YoussefBMK/viaduct/layouts/README.md

Hand-created KiCad board files live here, one directory per board:

    layouts/<board>/<board>.kicad_pcb

They are made by importing viaduct_v0.net in KiCad's PCB Editor -- see the README.
SKiDL cannot generate a board, so these files are not reproducible from source and are
committed as the source of truth for the physical layout.
