YoussefBMK/viaduct/viaduct_v0_sklib.py

from collections import defaultdict
from skidl import Pin, Part, Alias, SchLib, SKIDL, TEMPLATE

from skidl.pin import pin_types

SKIDL_lib_version = '0.0.1'

viaduct_v0 = SchLib(tool=SKIDL).add_parts(*[
        Part(**{ 'name':'USB_C_Receptacle_USB2.0_16P', 'dest':TEMPLATE, 'tool':SKIDL, 'aliases':Alias({'USB_C_Receptacle_USB2.0_16P'}), 'ref_prefix':'J', 'fplist':[''], 'footprint':'Connector_USB:USB_C_Receptacle_GCT_USB4105-xx-A_16P_TopMnt_Horizontal', 'keywords':'usb universal serial bus type-C USB2.0', 'description':'USB 2.0-only 16P Type-C Receptacle connector', 'datasheet':'https://www.usb.org/sites/default/files/documents/usb_type-c.zip', 'pins':[
            Pin(num='A1',name='GND',func=pin_types.PASSIVE,unit=1),
            Pin(num='A4',name='VBUS',func=pin_types.PASSIVE,unit=1),
            Pin(num='A5',name='CC1',func=pin_types.BIDIR,unit=1),
            Pin(num='A6',name='D+',func=pin_types.BIDIR,unit=1),
            Pin(num='A7',name='D-',func=pin_types.BIDIR,unit=1),
            Pin(num='A8',name='SBU1',func=pin_types.BIDIR,unit=1),
            Pin(num='A9',name='VBUS',func=pin_types.PASSIVE,unit=1),
            Pin(num='A12',name='GND',func=pin_types.PASSIVE,unit=1),
            Pin(num='B1',name='GND',func=pin_types.PASSIVE,unit=1),
            Pin(num='B4',name='VBUS',func=pin_types.PASSIVE,unit=1),
            Pin(num='B5',name='CC2',func=pin_types.BIDIR,unit=1),
            Pin(num='B6',name='D+',func=pin_types.BIDIR,unit=1),
            Pin(num='B7',name='D-',func=pin_types.BIDIR,unit=1),
            Pin(num='B8',name='SBU2',func=pin_types.BIDIR,unit=1),
            Pin(num='B9',name='VBUS',func=pin_types.PASSIVE,unit=1),
            Pin(num='B12',name='GND',func=pin_types.PASSIVE,unit=1),
            Pin(num='SH',name='SHIELD',func=pin_types.PASSIVE,unit=1)], 'unit_defs':[] }),
        Part(**{ 'name':'R', 'dest':TEMPLATE, 'tool':SKIDL, 'aliases':Alias({'R'}), 'ref_prefix':'R', 'fplist':[''], 'footprint':'Resistor_SMD:R_0603_1608Metric', 'keywords':'R res resistor', 'description':'Resistor', 'datasheet':'', 'pins':[
            Pin(num='1',func=pin_types.PASSIVE,unit=1),
            Pin(num='2',func=pin_types.PASSIVE,unit=1)], 'unit_defs':[] }),
        Part(**{ 'name':'USBLC6-2SC6', 'dest':TEMPLATE, 'tool':SKIDL, 'aliases':Alias({'USBLC6-2SC6'}), 'ref_prefix':'U', 'fplist':['Package_TO_SOT_SMD:SOT-666', 'Package_TO_SOT_SMD:SOT-23-6'], 'footprint':'Package_TO_SOT_SMD:SOT-666', 'keywords':'usb ethernet video', 'description':'Very low capacitance ESD protection diode, 2 data-line, SOT-23-6', 'datasheet':'https://www.st.com/resource/en/datasheet/usblc6-2.pdf', 'pins':[
            Pin(num='1',name='I/O1',func=pin_types.PASSIVE,unit=1),
            Pin(num='2',name='GND',func=pin_types.PASSIVE,unit=1),
            Pin(num='3',name='I/O2',func=pin_types.PASSIVE,unit=1),
            Pin(num='4',name='I/O2',func=pin_types.PASSIVE,unit=1),
            Pin(num='5',name='VBUS',func=pin_types.PASSIVE,unit=1),
            Pin(num='6',name='I/O1',func=pin_types.PASSIVE,unit=1)], 'unit_defs':[] }),
        Part(**{ 'name':'AP2112K-3.3', 'dest':TEMPLATE, 'tool':SKIDL, 'aliases':Alias({'AP2112K-3.3'}), 'ref_prefix':'U', 'fplist':['Package_TO_SOT_SMD:SOT-23-5', 'Package_TO_SOT_SMD:SOT-23-5'], 'footprint':'Package_TO_SOT_SMD:SOT-23-5', 'keywords':'linear regulator ldo fixed positive', 'description':'600mA low dropout linear regulator, with enable pin, 3.8V-6V input voltage range, 3.3V fixed positive output, SOT-23-5', 'datasheet':'https://www.diodes.com/assets/Datasheets/AP2112.pdf', 'pins':[
            Pin(num='1',name='VIN',func=pin_types.PWRIN,unit=1),
            Pin(num='2',name='GND',func=pin_types.PWRIN,unit=1),
            Pin(num='3',name='EN',func=pin_types.INPUT,unit=1),
            Pin(num='4',name='NC',func=pin_types.NOCONNECT,unit=1),
            Pin(num='5',name='VOUT',func=pin_types.PWROUT,unit=1)], 'unit_defs':[] }),
        Part(**{ 'name':'C', 'dest':TEMPLATE, 'tool':SKIDL, 'aliases':Alias({'C'}), 'ref_prefix':'C', 'fplist':[''], 'footprint':'Capacitor_SMD:C_0603_1608Metric', 'keywords':'cap capacitor', 'description':'Unpolarized capacitor', 'datasheet':'', 'pins':[
            Pin(num='1',func=pin_types.PASSIVE,unit=1),
            Pin(num='2',func=pin_types.PASSIVE,unit=1)], 'unit_defs':[] }),
        Part(**{ 'name':'ESP32-S3-WROOM-1', 'dest':TEMPLATE, 'tool':SKIDL, 'aliases':Alias({'ESP32-S3-WROOM-1'}), 'ref_prefix':'U', 'fplist':['RF_Module:ESP32-S3-WROOM-1'], 'footprint':'RF_Module:ESP32-S3-WROOM-1', 'keywords':'RF Radio BT ESP ESP32-S3 Espressif onboard PCB antenna', 'description':'RF Module, ESP32-S3 SoC, Wi-Fi 802.11b/g/n, Bluetooth, BLE, 32-bit, 3.3V, onboard antenna, SMD', 'datasheet':'https://www.espressif.com/sites/default/files/documentation/esp32-s3-wroom-1_wroom-1u_datasheet_en.pdf', 'pins':[
            Pin(num='1',name='GND',func=pin_types.PWRIN,unit=1),
            Pin(num='2',name='3V3',func=pin_types.PWRIN,unit=1),
            Pin(num='3',name='EN',func=pin_types.INPUT,unit=1),
            Pin(num='4',name='IO4',func=pin_types.BIDIR,unit=1),
            Pin(num='5',name='IO5',func=pin_types.BIDIR,unit=1),
            Pin(num='6',name='IO6',func=pin_types.BIDIR,unit=1),
            Pin(num='7',name='IO7',func=pin_types.BIDIR,unit=1),
            Pin(num='8',name='IO15',func=pin_types.BIDIR,unit=1),
            Pin(num='9',name='IO16',func=pin_types.BIDIR,unit=1),
            Pin(num='10',name='IO17',func=pin_types.BIDIR,unit=1),
            Pin(num='11',name='IO18',func=pin_types.BIDIR,unit=1),
            Pin(num='12',name='IO8',func=pin_types.BIDIR,unit=1),
            Pin(num='13',name='USB_D-',func=pin_types.BIDIR,unit=1),
            Pin(num='14',name='USB_D+',func=pin_types.BIDIR,unit=1),
            Pin(num='15',name='IO3',func=pin_types.BIDIR,unit=1),
            Pin(num='16',name='IO46',func=pin_types.BIDIR,unit=1),
            Pin(num='17',name='IO9',func=pin_types.BIDIR,unit=1),
            Pin(num='18',name='IO10',func=pin_types.BIDIR,unit=1),
            Pin(num='19',name='IO11',func=pin_types.BIDIR,unit=1),
            Pin(num='20',name='IO12',func=pin_types.BIDIR,unit=1),
            Pin(num='21',name='IO13',func=pin_types.BIDIR,unit=1),
            Pin(num='22',name='IO14',func=pin_types.BIDIR,unit=1),
            Pin(num='23',name='IO21',func=pin_types.BIDIR,unit=1),
            Pin(num='24',name='IO47',func=pin_types.BIDIR,unit=1),
            Pin(num='25',name='IO48',func=pin_types.BIDIR,unit=1),
            Pin(num='26',name='IO45',func=pin_types.BIDIR,unit=1),
            Pin(num='27',name='IO0',func=pin_types.BIDIR,unit=1),
            Pin(num='28',name='IO35',func=pin_types.BIDIR,unit=1),
            Pin(num='29',name='IO36',func=pin_types.BIDIR,unit=1),
            Pin(num='30',name='IO37',func=pin_types.BIDIR,unit=1),
            Pin(num='31',name='IO38',func=pin_types.BIDIR,unit=1),
            Pin(num='32',name='IO39',func=pin_types.BIDIR,unit=1),
            Pin(num='33',name='IO40',func=pin_types.BIDIR,unit=1),
            Pin(num='34',name='IO41',func=pin_types.BIDIR,unit=1),
            Pin(num='35',name='IO42',func=pin_types.BIDIR,unit=1),
            Pin(num='36',name='RXD0',func=pin_types.BIDIR,unit=1),
            Pin(num='37',name='TXD0',func=pin_types.BIDIR,unit=1),
            Pin(num='38',name='IO2',func=pin_types.BIDIR,unit=1),
            Pin(num='39',name='IO1',func=pin_types.BIDIR,unit=1),
            Pin(num='40',name='GND',func=pin_types.PASSIVE,unit=1),
            Pin(num='41',name='GND',func=pin_types.PASSIVE,unit=1)], 'unit_defs':[] }),
        Part(**{ 'name':'SW_Push', 'dest':TEMPLATE, 'tool':SKIDL, 'aliases':Alias({'SW_Push'}), 'ref_prefix':'SW', 'fplist':[''], 'footprint':'Button_Switch_SMD:SW_Push_1P1T_NO_CK_KMR2', 'keywords':'switch normally-open pushbutton push-button', 'description':'Push button switch, generic, two pins', 'datasheet':'', 'pins':[
            Pin(num='1',name='1',func=pin_types.PASSIVE),
            Pin(num='2',name='2',func=pin_types.PASSIVE)], 'unit_defs':[] }),
        Part(**{ 'name':'BME280', 'dest':TEMPLATE, 'tool':SKIDL, 'aliases':Alias({'BME280'}), 'ref_prefix':'U', 'fplist':['Package_LGA:Bosch_LGA-8_2.5x2.5mm_P0.65mm_ClockwisePinNumbering'], 'footprint':'Package_LGA:Bosch_LGA-8_2.5x2.5mm_P0.65mm_ClockwisePinNumbering', 'keywords':'Bosch pressure humidity temperature environment environmental measurement digital', 'description':'3-in-1 sensor, humidity, pressure, temperature, I2C and SPI interface, 1.71-3.6V, LGA-8', 'datasheet':'https://www.bosch-sensortec.com/media/boschsensortec/downloads/datasheets/bst-bme280-ds002.pdf', 'pins':[
            Pin(num='1',name='GND',func=pin_types.PWRIN,unit=1),
            Pin(num='2',name='CSB',func=pin_types.INPUT,unit=1),
            Pin(num='3',name='SDI',func=pin_types.BIDIR,unit=1),
            Pin(num='4',name='SCK',func=pin_types.INPUT,unit=1),
            Pin(num='5',name='SDO',func=pin_types.BIDIR,unit=1),
            Pin(num='6',name='VDDIO',func=pin_types.PWRIN,unit=1),
            Pin(num='7',name='GND',func=pin_types.PWRIN,unit=1),
            Pin(num='8',name='VDD',func=pin_types.PWRIN,unit=1)], 'unit_defs':[] }),
        Part(**{ 'name':'LED', 'dest':TEMPLATE, 'tool':SKIDL, 'aliases':Alias({'LED'}), 'ref_prefix':'D', 'fplist':[''], 'footprint':'LED_SMD:LED_0603_1608Metric', 'keywords':'LED diode', 'description':'Light emitting diode', 'datasheet':'', 'pins':[
            Pin(num='1',name='K',func=pin_types.PASSIVE,unit=1),
            Pin(num='2',name='A',func=pin_types.PASSIVE,unit=1)], 'unit_defs':[] })])
