YoussefBMK/viaduct/(commit log)

2026-10-03 Scaffold Viaduct atopile project with kicad-cli tooling
    Sets up the repo structure so design work can start against a validated
    toolchain: uv-managed atopile 0.15, kicad-cli wrappers for ERC/DRC/Gerber
    export with JSON reports and CI-friendly exit codes, and a timing harness
    to catch build-cost regressions as the design grows.
    No circuit yet -- main.ato is intentionally absent.
2026-10-03 Add uv.lock pinning atopile 0.15.9 on Python 3.14
    Resolved under WSL2 Ubuntu 24.04; the Windows wheel for atopile 0.15.9
    ships AVX-512 Zig extensions that trap on this CPU (atopile#1838).
2026-10-03 Verify the toolchain end to end under WSL2 and fix what that exposed
    Everything in the original scaffold was unverified. Running it for real
    required moving off native Windows: atopile's Windows wheels crash with
    STATUS_ILLEGAL_INSTRUCTION on CPUs without AVX-512 (atopile#1838).
    Add main.ato as a deliberately pick-free smoke-test fixture so the whole
    pipeline can run offline and unauthenticated -- any part atopile must
    resolve against its database forces `ato auth login`. The generated
    layout gets a hand-added Edge.Cuts rectangle because atopile emits no
    board outline, without which DRC fails on a malformed outline.
    Separate "nothing was checked" from "passed": erc.py now exits 3 when no
    s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
    [default.kicad_pcb]
2026-10-04 Describe the V0 board in SKiDL after atopile's registry went dead
    atopile's package registry host packages.atopileapi.com now returns an
    authoritative NXDOMAIN, so `ato add` cannot resolve anything and its CLI is in
    maintenance mode. Worse, search_registry_packages() swallows the failure in a
    bare `except Exception: return []`, which makes a dead network look exactly
    like "no such package" -- a good way to end up inventing part numbers.
    This branch evaluates SKiDL as the replacement front end and uses it to write
    the first real circuit: ESP32-S3-WROOM-1, BME280 over I2C, USB-C power with
    native USB, AP2112K-3.3 LDO and a USBLC6-2 ESD array.
    Every part is a stock KiCad 10 symbol with a stoc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
    [viaduct_v0.py, viaduct_v0_sklib.py]
2026-10-04 Validate footprints against the real KiCad libraries and cite Rd
    SKiDL accepts any footprint string unchecked -- it warns that fp-lib-table was
    not found and then passes the string straight into the netlist, so a mistyped
    library nickname or a footprint whose pads do not line up with the symbol pins
    is not caught until KiCad import time. scripts/check_footprints.py resolves
    every part Lib:Name against the installed *.pretty libraries (honouring a real
    fp-lib-table when one exists) and asserts every symbol pin number has a pad
    with that number.
    Negative-tested against four injected faults: unknown footprint name, unknown
    library nickname, right library with the wrong pad count (SOT-23 under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
    [viaduct_v0.py]
2026-10-05 Remove atopile and make the SKiDL design the only build path
    atopile's package registry host is decommissioned, so the .ato front end could
    no longer resolve parts and had no path forward. Delete it rather than leave a
    second, broken way to build the board: ato.yaml, the main.ato smoke fixture, the
    atopile-generated layouts/default/, and the dependency.
    The kicad-cli wrappers are kept and repointed:
    - erc.py now runs SKiDL's ERC against viaduct_v0.py instead of "kicad-cli sch
    erc". atopile never produced a .kicad_sch, so that check could only ever exit
    3 "not applicable"; SKiDL's ERC always has a design to run against, which
    retires exit 3 and the --allow-missing flag along with it.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
    [default.kicad_pcb]
